MichaelADiazM/George-L2-and-L3-Electronics-Hell/references/dht20pinout.png

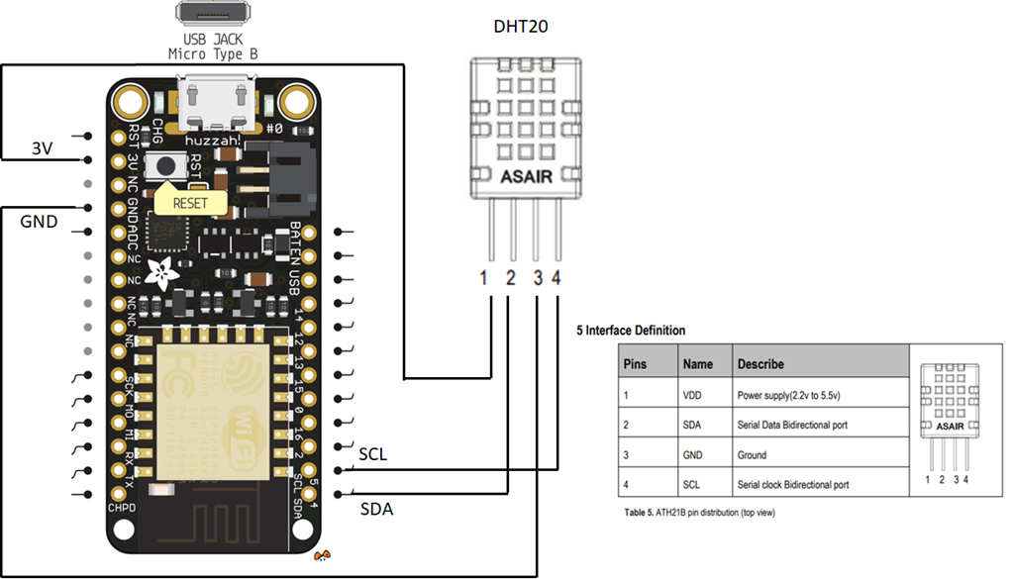
references/dht20pinout.png
