MichaelADiazM/George-L2-and-L3-Electronics-Hell/references/esp32-c61-devkitc-1-pin-layout-v2.png

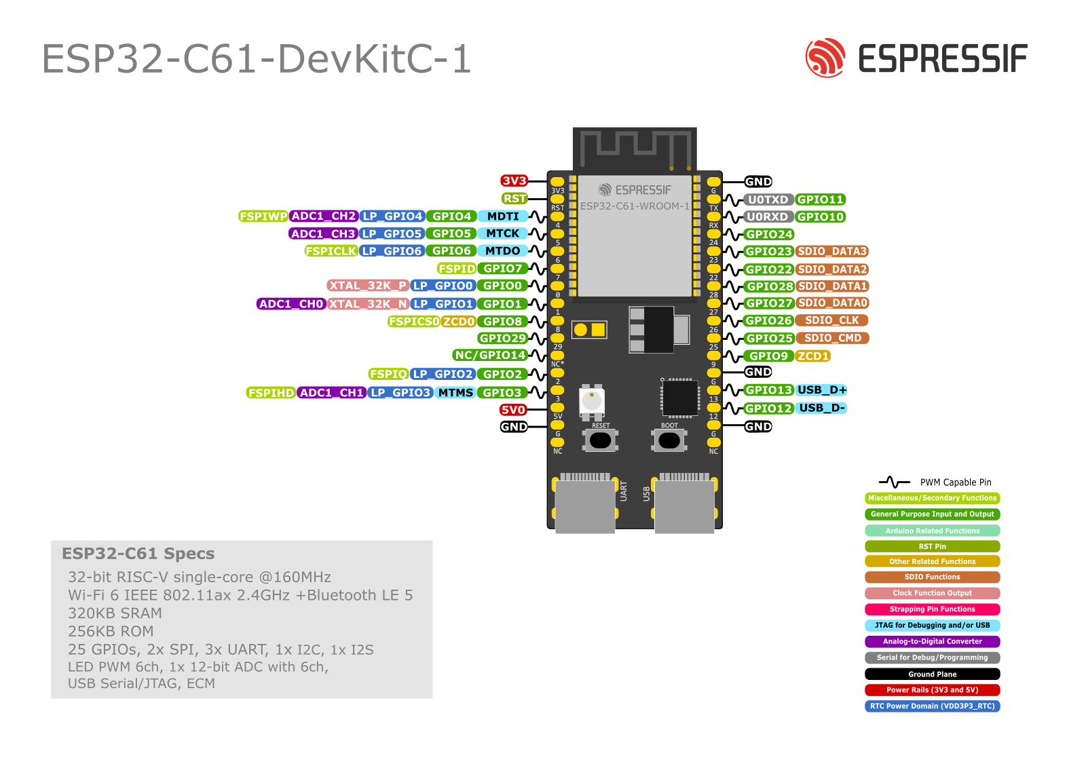
references/esp32-c61-devkitc-1-pin-layout-v2.png
