MichaelADiazM/George-L2-and-L3-Electronics-Hell/(commit log)

2026-05-26 - Separated the readings for the BMP390 and DHT20; - Added two-way communication functionality; - Cleaned most of the bugs made until this stage; - Created stump files for the logger --- Next steps: 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
    [config.h, logger.h, sensor.cpp, sensor.h, server.h]
2026-05-31 Improvements: - Fleshed out logger and radio modules - Added a CMake build system and VSCode configuration for easier development - Adapted structure to support the new ESP32-C61, which isn't well su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
    [main.cpp, radio.cpp, radio.h]
2026-05-31 Changes: 1. Fix: Corrected print statement in main.ino to include missing semicolon and ensure proper function call. 2. Fix: Updated logger.h to reflect changes in logReading function and removed unu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
    [logger.cpp, logger.h, main.cpp, sensor.cpp]
2026-09-17 Docs: Add comprehensive documentation to sensor, logger, and radio headers
    - Fixed sensor.h file header to correctly reference BMP390 (was DHT20)
    - Added missing function docs for readBmp() in sensor.h
    - Added struct field comments to BmpReading
    - Filled empty file header in logger.h with description and responsibility
    - Added function docs for initLogger, logReading, flushLogs
    - Added struct field comments to LogEntry
    - Filled empty file header in radio.h with description and responsibility
    - Added function docs for initRadio and transmitReading
    - Completed struct field comments in RadioPacket (fixed empty comment on temperatureC, added missing comments for pressureHpa and altitudeM)
    All h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
    [logger.h, radio.h, sensor.h]
2026-09-17 Build: Remove unused managed_components and update configuration
    - Removed espressif__esp-dsp managed component (not used in project)
    - Updated dependencies.lock, config.h, main.ino, server.cpp
    - Updated components/arduino submodule reference
2026-09-18 Docs: Align README with actual implementation, add wiring diagram
    - Add docs/wiring-diagram.svg: real breadboard-style diagram using
    actual hardware (ESP32-C61-DevKitC-1, Adafruit BMP390 STEMMA QT,
    Adafruit RFM69HCW, generic microSD breakout) with color-coded wires
    and full pinout reference tables
    - Correct every GPIO reference throughout the README to match
    main/config.h (I2C SDA=28/SCL=27, SPI SCK=6/MOSI=7/MISO=2, radio
    CS=5/INT=8, SD CS=4) - previous docs used stale placeholder pins
    - Fix Server Module docs to match server.cpp: remove fictional /data
    JSON route (only / HTML exists), correct WiFi mode (WIFI_AP_STA runs
    both AP and STA simultaneously, not either/or), correct r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
    [config.h, main.cpp, sensor.cpp]
2026-09-18 Docs: Fix wiring diagram to show both ESP32-C61 header columns
    The previous diagram only showed a single pin column, implying all
    wiring goes to one side of the board. The real ESP32-C61-DevKitC-1
    has two header columns, and this project genuinely uses both:
    BMP390 (SDA=GPIO28, SCL=GPIO27) connects to the right header, while
    RFM69 and the SD card (GPIO 2/4/5/6/7/8) connect to the left header.
    - Redraw docs/wiring-diagram.svg with both columns in the board's
    real silkscreen order (verified against Espressif's official
    pinout diagram), showing all 15 pins per side - used pins bold
    and colored, unused pins as small gray dots for context
    - Flag the one genuinely awkward connection: this b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
2026-09-18 Feature: Real-time telemetry system (ground station + relay + cloud dashboard)
    Add a complete end-to-end pipeline for viewing flight telemetry live:
    - ground-station/: Arduino sketch for a second ESP32+RFM69 receiver that
    demodulates flight computer's 915MHz packets and outputs NDJSON over serial
    at 115200 baud. Includes config.h (pin assignments) and radio_packet.h
    (wire format definition, guarded by static_assert to stay in sync with
    main/radio.h).
    - relay/: Python script (pyserial + requests) that reads serial NDJSON from
    the ground station, logs every packet locally to relay/logs/<session>.ndjson
    (resilience backstop — nothing is lost regardless of internet), and relays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
2026-09-21 Feature: Add real-time telemetry system (ground station + relay + cloud dashboard)
    - Ground station firmware (ESP32 + RFM69 receiver) that emits NDJSON over serial
    - Python relay script with auto-reconnect, local logging, and cloud ingest
    - Next.js cloud dashboard deployed via Vercel with Postgres backend
    - Full integration guide in TELEMETRY.md
    See TELEMETRY.md for hardware setup, build instructions, and deployment guide.
2026-09-26 Docs: Add dev log and UML diagrams for the telemetry system
    DEVLOG.md is a working baseline of current architecture and known
    issues across main/, ground-station/, and relay/, meant to anchor
    an upcoming refactor. UML.md adds class diagrams for each subsystem
    plus an object-diagram snapshot of runtime instances.
